antocuni/astroscad/(list of files, cad)

Other CAD files:
v2/pyscad/vendored/gears/gears.scad
