antocuni/astroscad/v2/pyscad/test/screenshots/TestBasic.test_cube.png

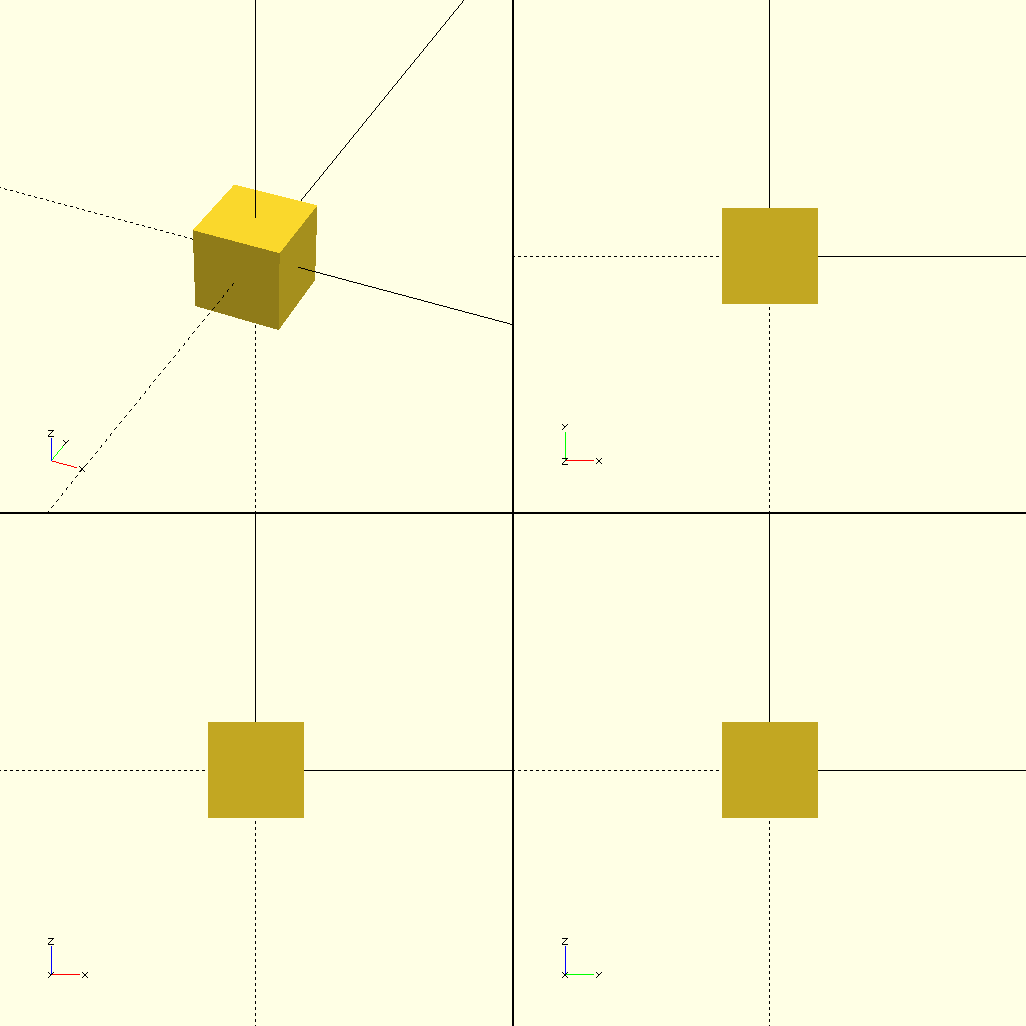
v2/pyscad/test/screenshots/TestBasic.test_cube.png
