antocuni/astroscad/v2/pyscad/test/screenshots/TestBasic.test_cylinder.png

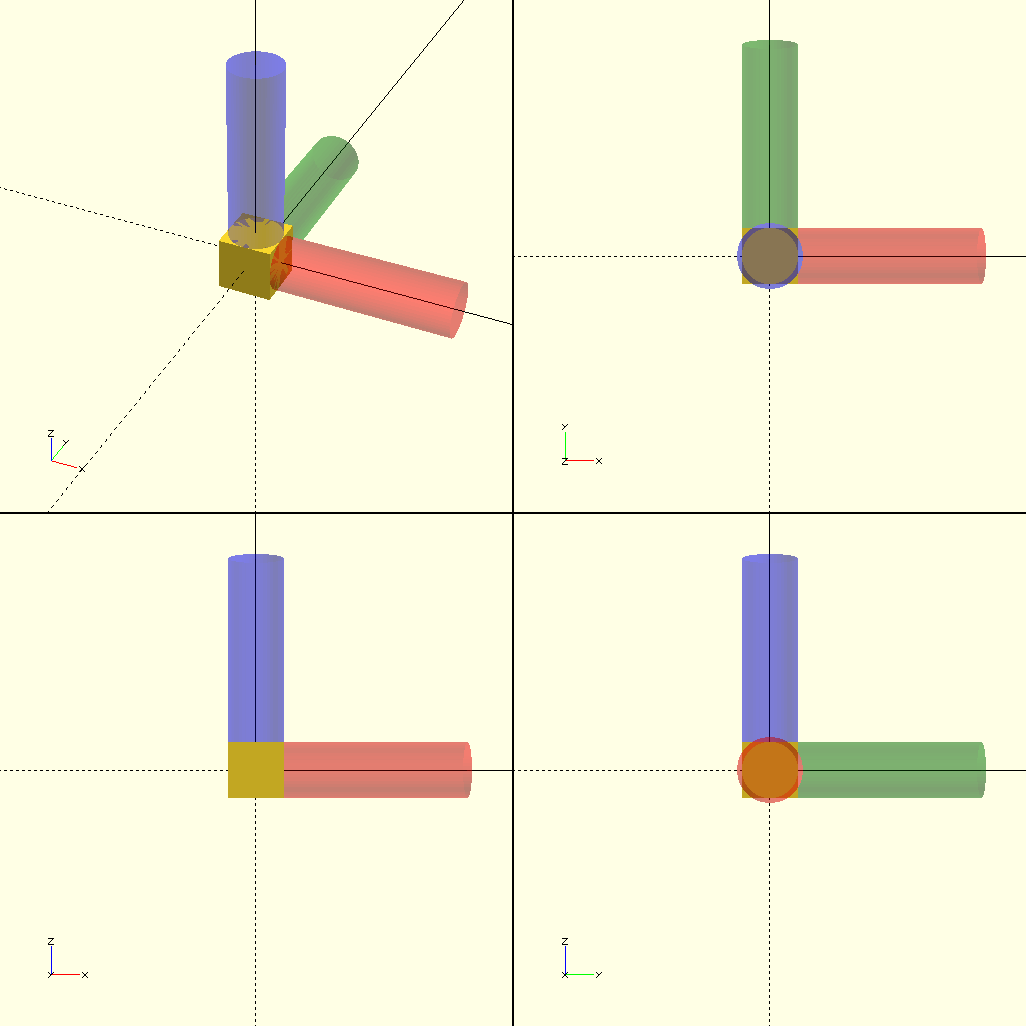
v2/pyscad/test/screenshots/TestBasic.test_cylinder.png
