antocuni/astroscad/v2/pyscad/test/screenshots/TestBasic.test_Difference.png

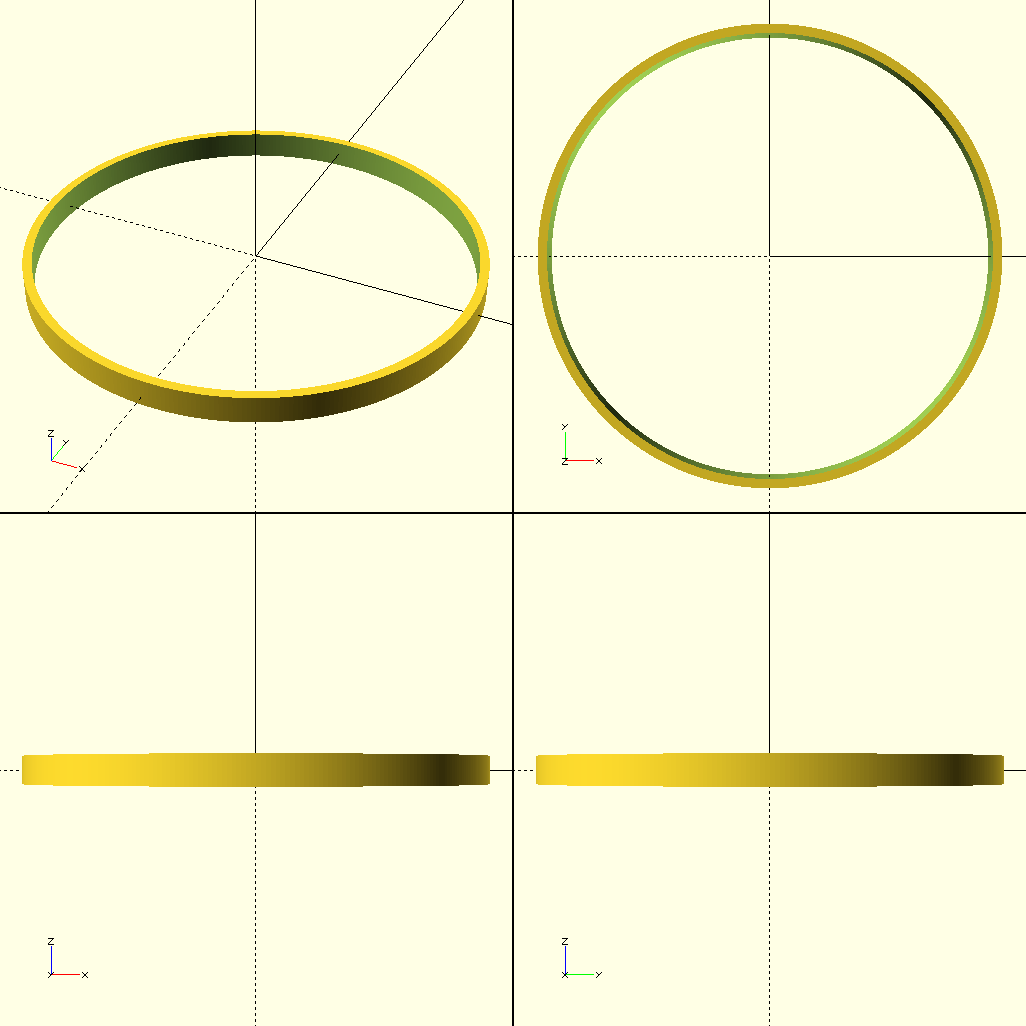
v2/pyscad/test/screenshots/TestBasic.test_Difference.png
