antocuni/astroscad/v2/pyscad/test/screenshots/TestBasic.test_move_to.png

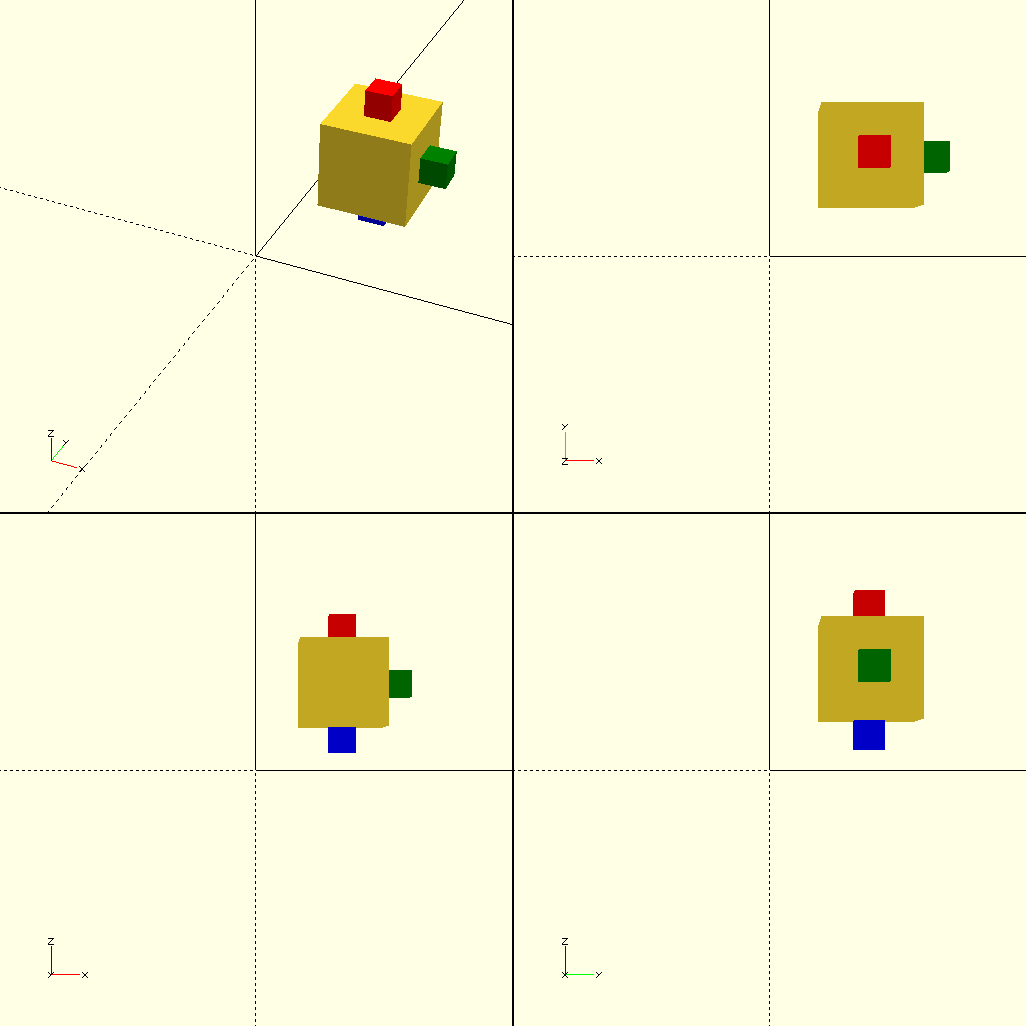
v2/pyscad/test/screenshots/TestBasic.test_move_to.png
