antocuni/astroscad/v2/pyscad/test/screenshots/TestBasic.test_sphere.png

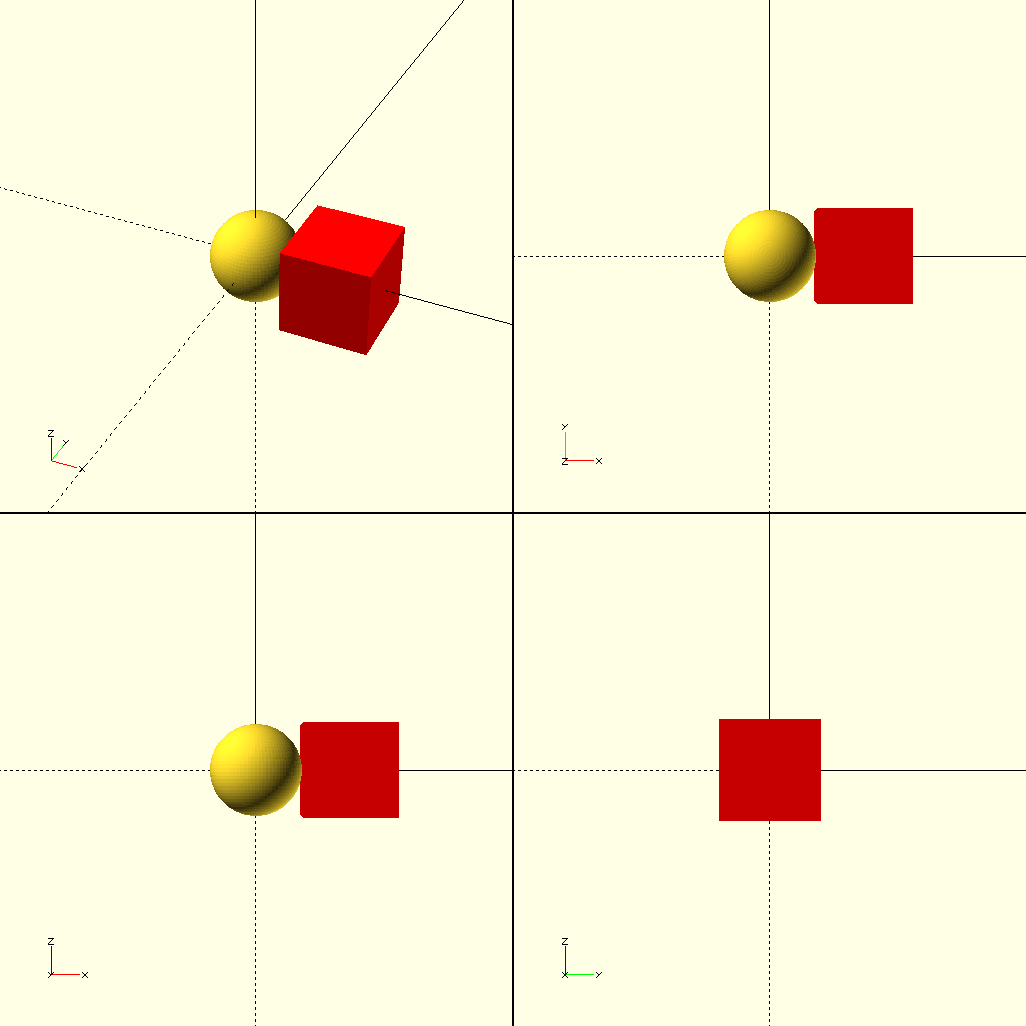
v2/pyscad/test/screenshots/TestBasic.test_sphere.png
