antocuni/astroscad/v2/pyscad/test/screenshots/TestGear.test_bracket.png

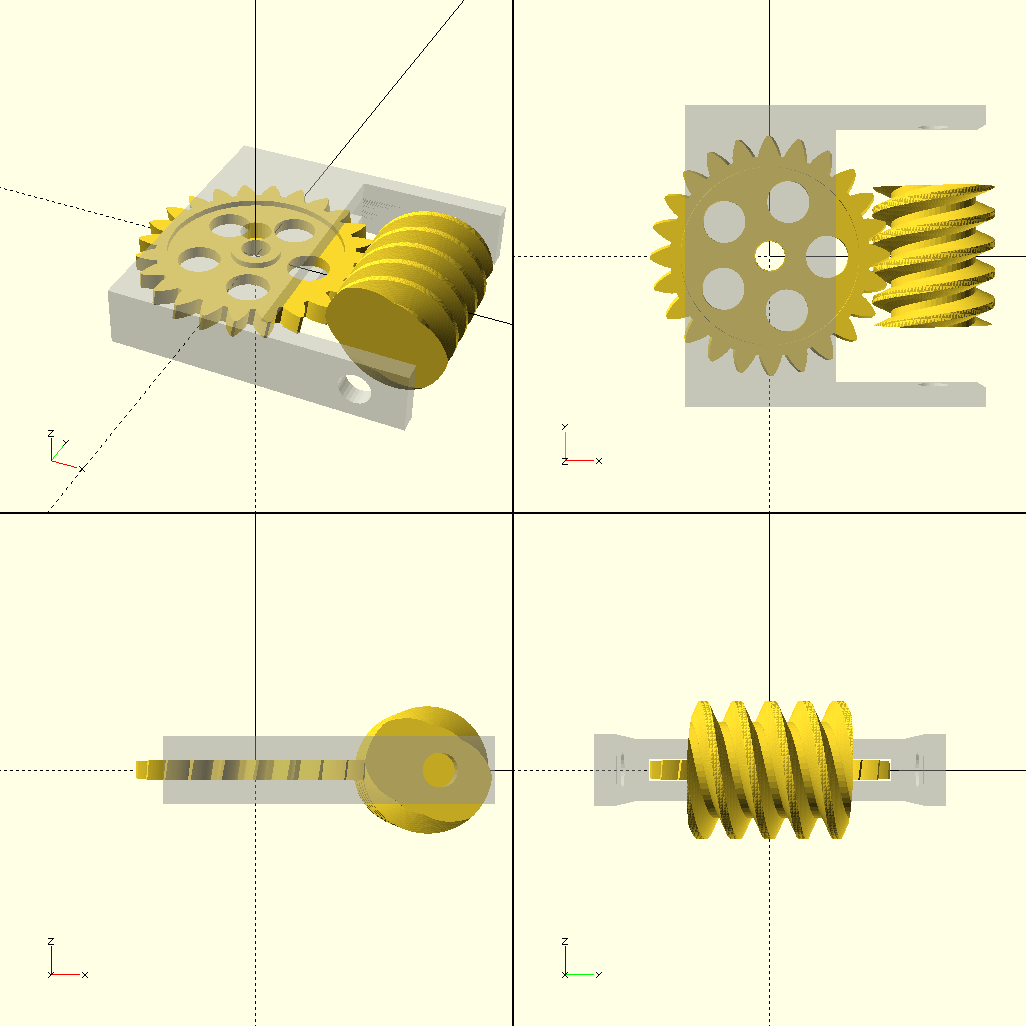
v2/pyscad/test/screenshots/TestGear.test_bracket.png
