antocuni/astroscad/v2/pyscad/test/screenshots/TestGear.test_spur_other_axes.png

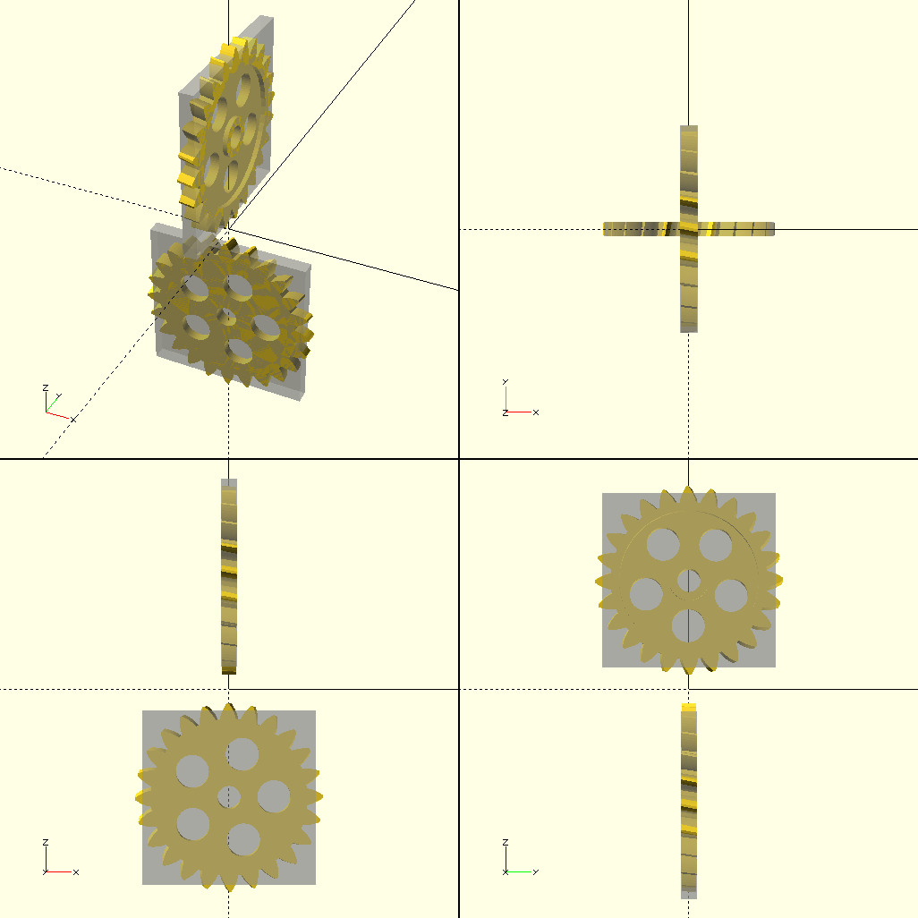
v2/pyscad/test/screenshots/TestGear.test_spur_other_axes.png
