antocuni/astroscad/v2/pyscad/test/screenshots/TestGear.test_spur_simple.png

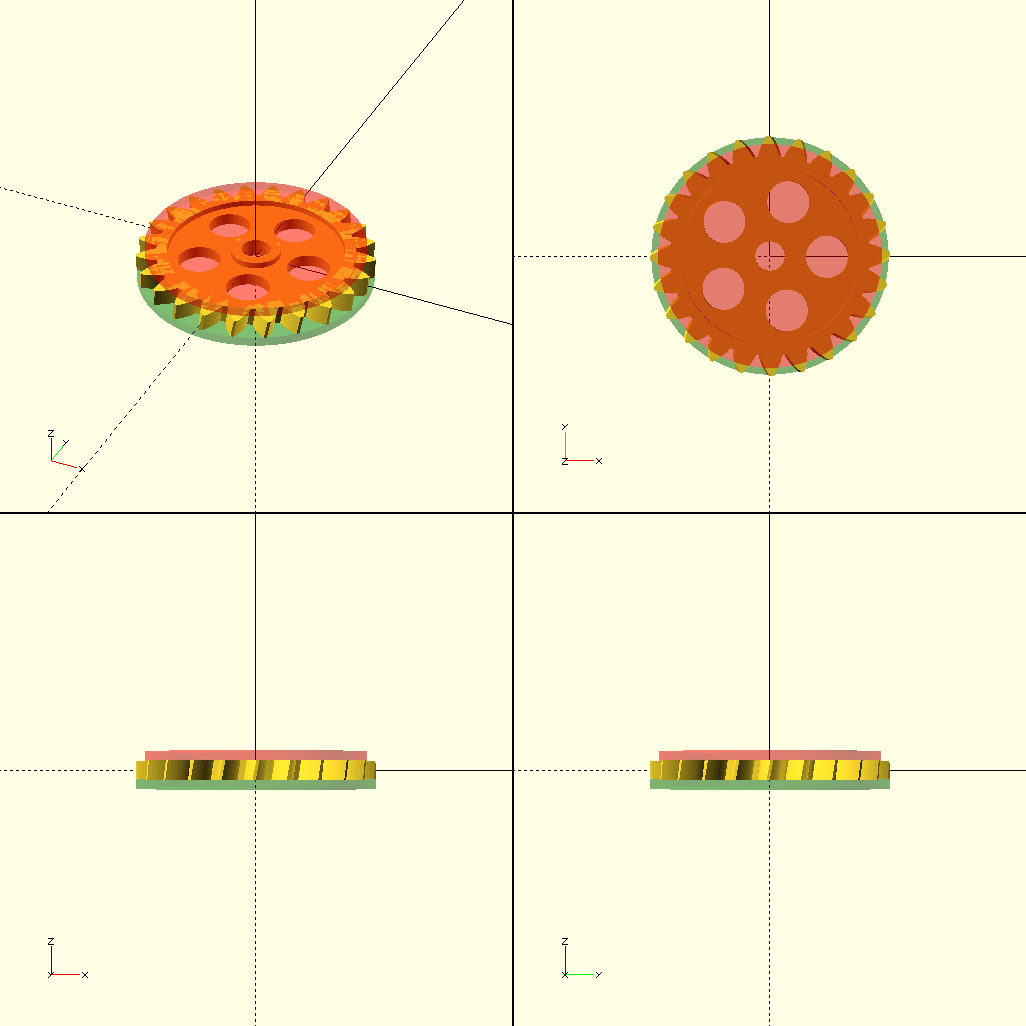
v2/pyscad/test/screenshots/TestGear.test_spur_simple.png
