antocuni/astroscad/v2/pyscad/test/screenshots/TestLib.test_bearing.png

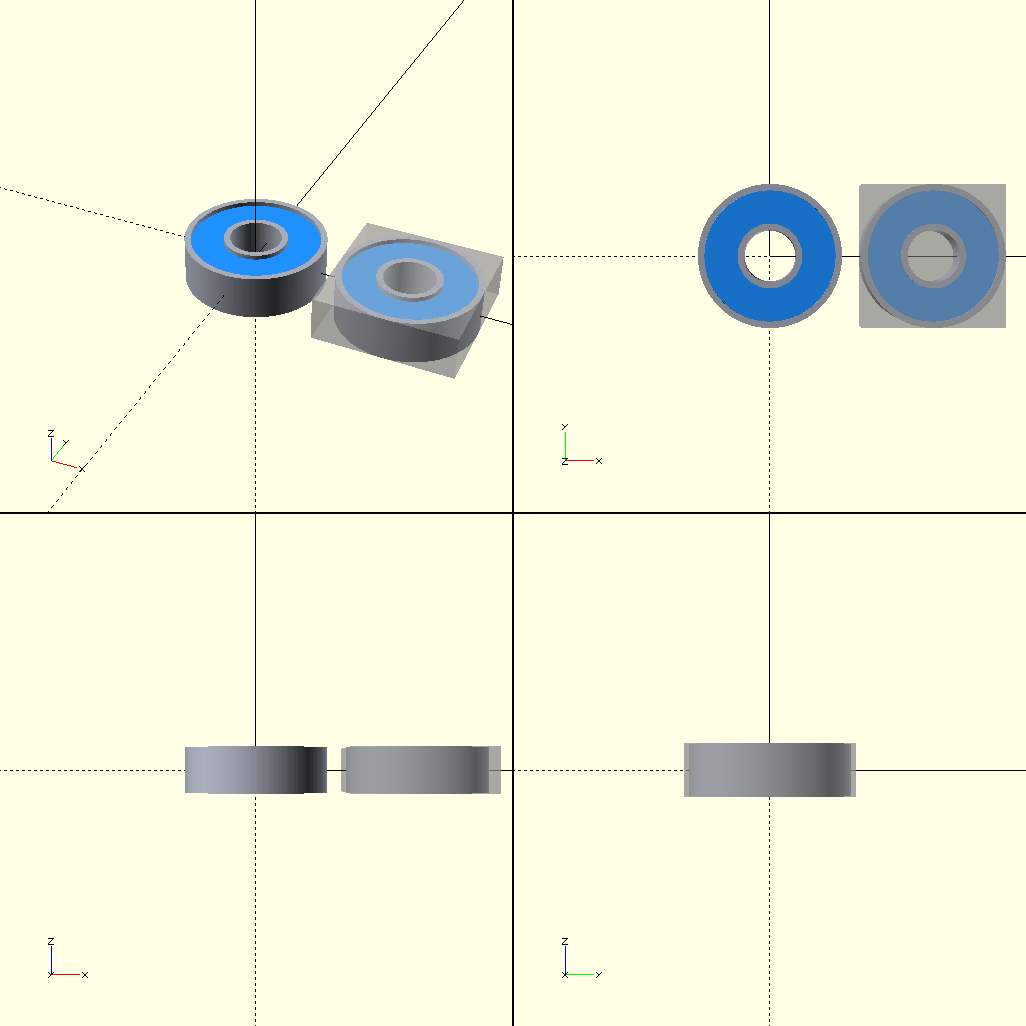
v2/pyscad/test/screenshots/TestLib.test_bearing.png
