antocuni/astroscad/v2/pyscad/test/screenshots/TestRoundHole.test_negative.png

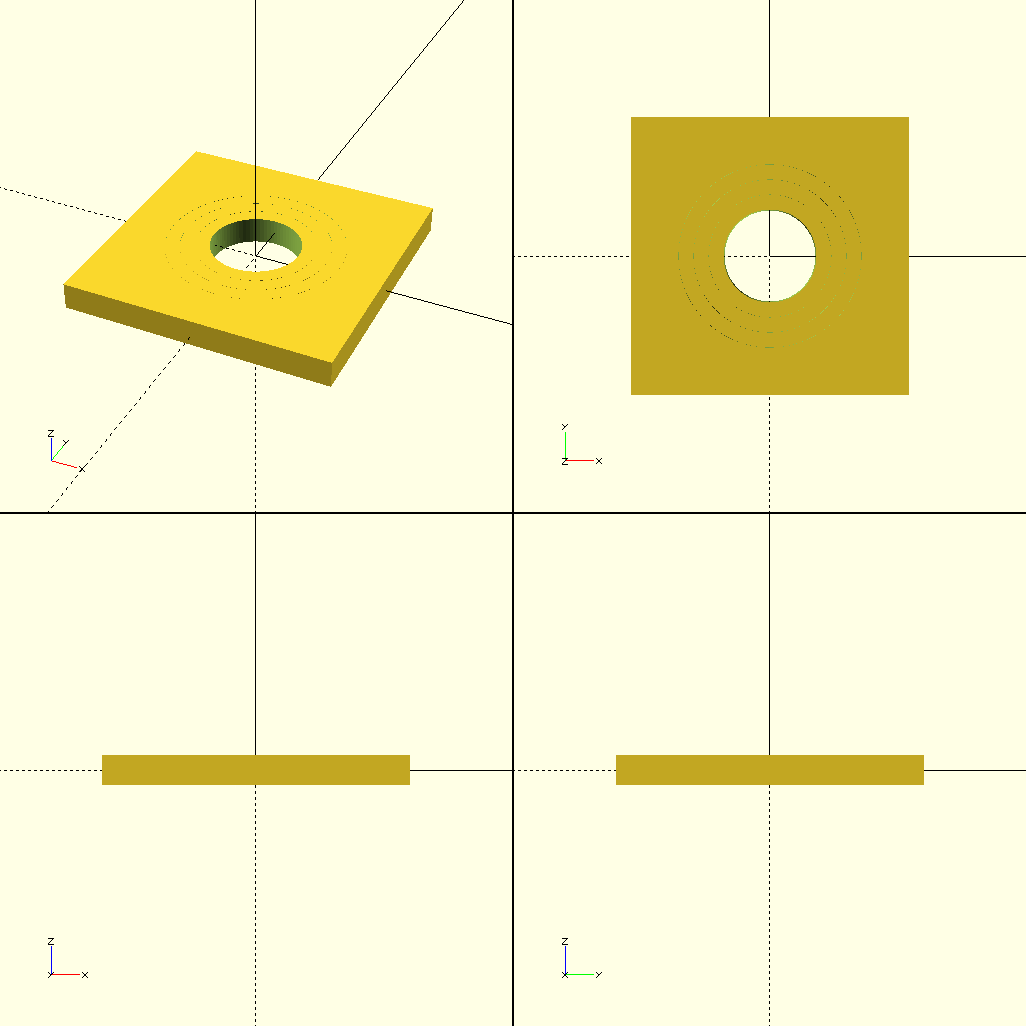
v2/pyscad/test/screenshots/TestRoundHole.test_negative.png
