antocuni/astroscad/v2/pyscad/test/screenshots/TestShapes.test_DonutSlice.png

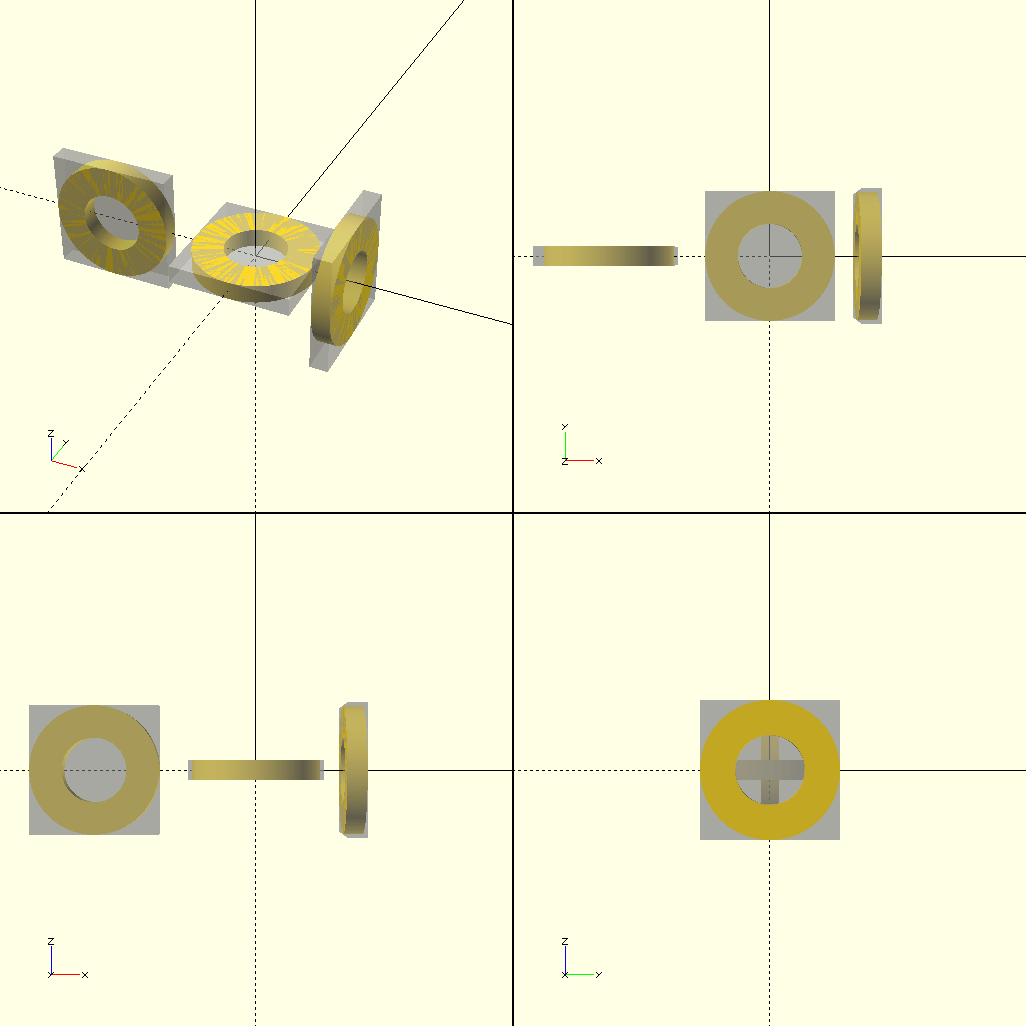
v2/pyscad/test/screenshots/TestShapes.test_DonutSlice.png
