antocuni/astroscad/v2/pyscad/test/screenshots/TestStepper_48BYJ48.test_motor.png

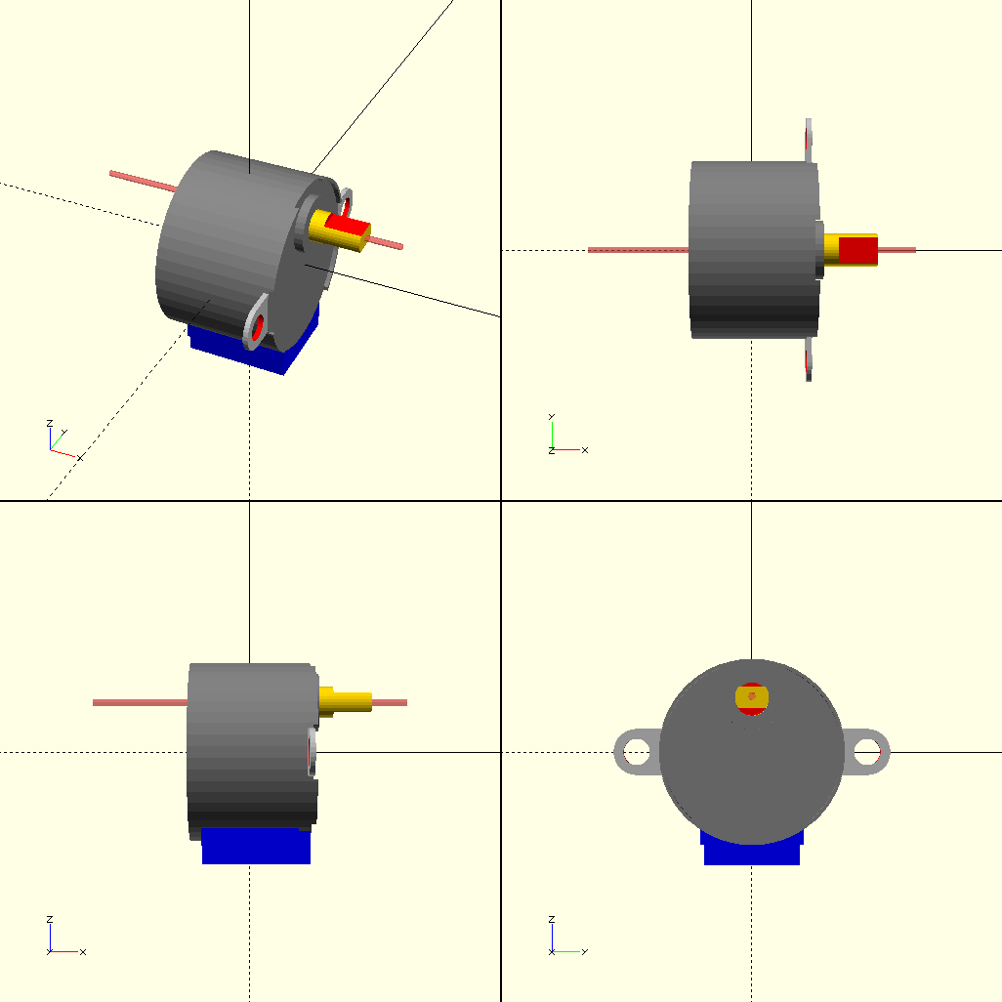
v2/pyscad/test/screenshots/TestStepper_48BYJ48.test_motor.png
