antocuni/astroscad/v2/pyscad/test/screenshots/TestStepper_48BYJ48.test_mounting_holes.png

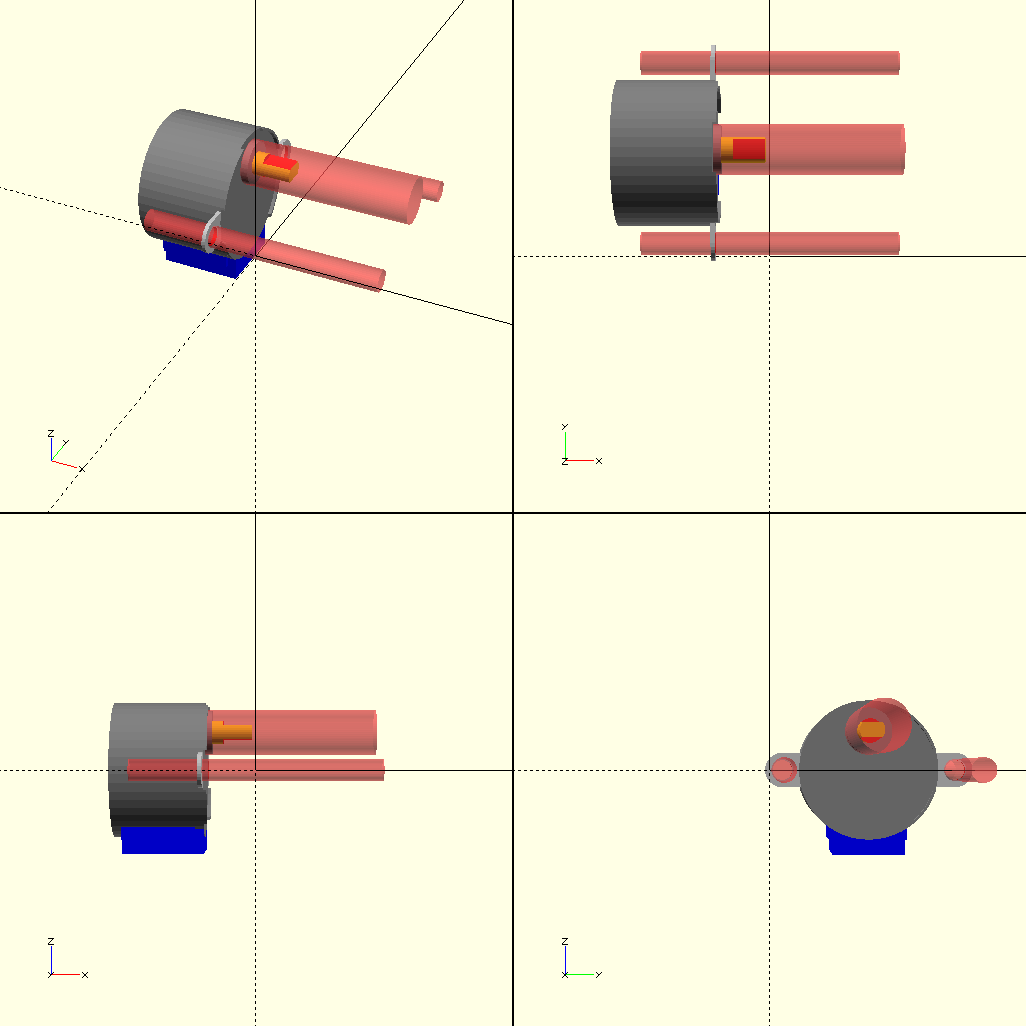
v2/pyscad/test/screenshots/TestStepper_48BYJ48.test_mounting_holes.png
