antocuni/astroscad/v2/try_preview.py

#!/usr/bin/python3

import os
from pyscad import autorender, Cube, Cylinder, Preview

class CubeOrCylinder(Preview):

    def preview(self):
        return Cube(10, 10, 10)

    def render(self):
        return Cylinder(d=10, h=10)


def main():
    return CubeOrCylinder()


if __name__ == '__main__':
    main().autorender()
