antocuni/astroscad/(commit log)

2021-03-17 initial checkin: start to design the upper plate of the tracker
    [astro.scad]
2021-03-17 add the hole for the ball head
    [astro.scad]
2021-03-17 display also the head of the PH38 bolt
    [astro.scad]
2021-03-17 add animation
    [astro.scad]
2021-03-17 make inner_hinge a module of its own
    [astro.scad]
2021-03-17 take the nut into account
    [astro.scad]
2021-03-17 use a more reasonable height for the ball head
    [astro.scad]
2021-03-17 more renaming
    [astro.scad]
2021-03-17 start to model the lower plate
    [astro.scad]
2021-03-17 use a global variable to show vitamins
    [astro.scad]
2021-03-17 display also the bearings
    [astro.scad]
2021-03-18 improve the upper plate
    [astro.scad]
2021-03-18 small tweaks
    [astro.scad]
2021-03-18 more tweaks
    [astro.scad]
2021-03-18 make this hole slightly bigger
    [astro.scad]
2021-03-19 add the threaded rod and a hole in the upper plate
    [astro.scad]
2021-03-19 fix the lower plate
    [astro.scad]
2021-03-19 simplify & fix the upper plate
    [astro.scad]
2021-03-19 add a hole for the PH38 nut
    [astro.scad]
2021-03-19 make the small upper plate shorter, else it covers the PH38 hole
    [astro.scad]
2021-03-19 make the lower plate exactly as thick as the bearing slots
    [astro.scad]
2021-03-19 add a hole for the threaded rod also to the lower plate
    [astro.scad]
2021-03-19 this is the right dimension to comfortably hold a PH14 nut
    [astro.scad]
2021-03-19 This is the precise dimension of my rod
    [astro.scad]
2021-03-19 add slot+hole for the PH14 nut+bolt, to fasten the quick-release plate
    [astro.scad]
2021-03-19 move the ball head closer to the hinge
    [astro.scad]
2021-03-19 add a very rough model of the thrust bearings
    [thrust_bearing.scad]
2021-03-19 add the model for the gear with a nut embedded
    [gear_with_nut.scad, thrust_bearing.scad]
2021-03-19 shift everything down so that the inner nut is precisely centered, it makes it easier to use in the main model
    [gear_with_nut.scad]
2021-03-20 add the driver gear
    [astro.scad, gear_with_nut.scad, thrust_bearing.scad]
2021-03-20 add a thrust bearing and the corresponding washer
    [astro.scad]
2021-03-20 add the upper thrust bearing
    [astro.scad]
2021-03-20 refactor the way the gear cavity is done. This way should be easier to apply it also to the upper plate
    [astro.scad]
2021-03-20 add some notches to the bearing slots, to make it easier to measure angles
    [astro.scad]
2021-03-20 WIP: start to add the gear cap
    [astro.scad, thrust_bearing.scad]
2021-03-20 WIP: start to add pillars to the gear cap
    [astro.scad]
2021-03-20 add holes for the screw
    [astro.scad, screw_holes.scad]
2021-03-20 use the official tolerance
    [astro.scad]
2021-03-20 add a hole for the threaded rod into the gear cap
    [astro.scad]
2021-03-20 add holes for the pillar screws in the lower plate
    [astro.scad]
2021-03-20 add slots for the nuts
    [astro.scad]
2021-03-20 use a higher tolerance, else the screw does not fit comfortably in the hole
    [astro.scad]
2021-03-20 the the nut slot taller
    [astro.scad]
2021-03-20 revert to the old tolerance. If I print with standard settings, it prints fine
    [astro.scad]
2021-03-20 WIP: add the stepper motor and the corresponding gear
    [StepMotor_28BYJ-48.scad, astro.scad, gear_with_nut.scad, stepper.scad]
2021-03-20 make a cavity for the gear cap in the upper plate so that we can still close the tracker
    [astro.scad]
2021-03-20 try another approach to make space for the gear cap
    [astro.scad]
2021-03-20 make it possible to have different upper and lower lengths
    [astro.scad]
2021-03-20 make the whole design simpler
    [astro.scad]
2021-03-20 add a hole for this nut
    [astro.scad]
2021-03-20 as the comment say
    [astro.scad]
2021-03-20 improve the rendering in preview mode
    [astro.scad, gear_with_nut.scad]
2021-03-20 start to add holes for the stepper
    [astro.scad, stepper.scad]
2021-03-20 add the two holes to mount the stepper
    [astro.scad, stepper.scad]
2021-03-20 make the pillars of the gear cap more stable
    [astro.scad]
2021-03-20 slightly enlarge the hole of the gear cap screws
    [astro.scad]
2021-03-20 add a slot for another thrust bearing, in case it will be needed
    [astro.scad]
2021-03-20 add a shaft to the stepper gear, with the appropriate hole
    [astro.scad, stepper.scad]
2021-03-21 add a washer to the stepper gear
    [stepper.scad]
2021-03-21 make a module for stepper_gear in astro.scad, so that we can print it from there with the correct dimensions
    [astro.scad, stepper.scad]
2021-03-21 enlarge a bit this hole, it turned out too tight when printed
    [astro.scad]
2021-03-24 introduce 'curved washers' to keep the rod in place
    [astro.scad]
2021-03-26 these are the best settings for my printer
    [thrust_bearing.scad]
2021-03-26 introduce my_nutHole, which lets to specify the exact height of the nut
    [gear_with_nut.scad]
2021-03-26 use a smaller cut-through hole to improve the quality of the washer holes
    [gear_with_nut.scad]
2021-03-26 refactor curved_washers
    [astro.scad]
2021-03-26 add some todo
    [astro.scad]
2021-04-03 add a more friendly wrapper for cylinder
2021-04-03 create an adapter to put 1/4" screws into a 608 bearing
2021-04-03 add a method to make a bearing slot
2021-04-04 add a bracket to test spur+worm gears
2021-04-04 add some more shortcuts
    [astro.py]
2021-04-04 fix bolt_hole(center=True)
2021-09-04 refactor Cylinder
2021-09-06 attach anchors to Cube and start to write test for that
2021-09-06 fix try_gears in preparation of a bigger refactoring
    [try_gear.py]
2021-09-06 re-implement Cylinder
2021-09-07 refactor how Composite and move_to are implemented: instead of relying on implicitly looking up the PySCADObject attributes, we explicitly keep track of children
2021-09-07 attach useful info such as size, r, d, h to some primitive objects
2021-09-07 vendor the gears library from https://github.com/chrisspen/gears, commit e07935c
    [gears.scad]
2021-09-07 move the logic to set OPENSCADPATH directly into scad.py and remove it from all the scripts. Start to write gears.py which is a wrapper around gears.scad
2021-09-07 play with gears
2021-09-08 introduce a high level WormFactory, and use it to greatly simplify the gears example
    [gears.scad]
2021-09-09 I mistakenly committed a version with local edits. Revert gears.scad back to commit e07935c of https://github.com/chrisspen/gears
    [gears.scad]
2021-11-09 add an option to show the tests inside openscad and make it possible to create cylinders of different orientations
2021-11-09 add a bearing class, inspired by MCAD/bearing.scad
2021-11-09 make it possible to change the camera distance when rendering collages, and use it for test_bearing
2021-11-09 move gears.py into lib/
2021-11-12 introduce a vendored library to render a Manfrotto 200PL plate
    [manfrotto-200PL-003.scad]
2021-11-12 attacch a manfrotto plate to the baseplate
2021-12-19 add the version with holes of the manfrotto plate
2021-12-19 tweak the model to use a real manfrotto plate which will be screwed
2021-12-21 introduce the bearing-bolt adapter and the actual bolt
2021-12-21 make the baseplate higher so that it fully contains the bearing and there is space to attach the photo plate again
2021-12-22 use Spure.bore_d instead of manually subtracting a cylinder
2021-12-23 don't require a specific version of psutil, so that it can use one with linux wheels
2021-12-26 add RoundHole, a Cylinder-like hole which automatically adds reinforing walls
2021-12-27 add screw holes to attach the photo plate to the base plate
2021-12-27 add some extra walls around the central bearing
2021-12-27 show the hex hole inside the PHBolt head, just because
2021-12-27 make it possible to align spur gears along all axes
2021-12-27 re-design WormGear to be more consistent with the rest of the cylinder-like objects. Now it has an 'h' instead of a 'length', it lays on the z axis by default and it's possible to change the orientat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
2021-12-27 star to design the worm gear, and attach a spur to it
2021-12-27 move the worm in the X axis
2021-12-28 start to design the worm mounting bracket
2021-12-28 add the bracket also to the main model
2021-12-28 squeeze everything down: the ball head is on top of the rplate, and the rplate on top top of the base plate. Add a warning if the bolt is too long
    [astro.py]
2021-12-28 add another print
2021-12-29 resume the black color of the ball head, and mod() it only if you need to inspect the bolt inside
2021-12-29 rough attempt to add a semi-configurable calibration system
2021-12-29 add support for making grooves for the manfrotto plate
2021-12-29 add a groove for the manfrotto plate so that it's easier to center
2021-12-29 make it easier to debug the screw hole limit
2021-12-29 move the baseplate so that its bottom is at z=0, and fix a bug in the position of the bearing
    [astro.py]
2022-01-10 make the spur thicker, else the PHBolt is too long for the ball head
    [astro.py]
2022-01-10 enable fast-rendering of worm and spur gears: in this mode, they are rendered as plain cylinders
2022-01-26 fix the length of the PHBolt, which was wrong. In the meantime, add measurements for another 1.25" bolt which I have
    [astro.py]
2022-01-26 we can make the rplate thinner now that the bolt length has been fixed
    [astro.py]
2022-01-27 add a library to render the stepper motor 28BYJ-48
    [StepMotor_28BYJ-48.scad]
2022-01-27 generate mounting holes for the stepper
2022-01-28 introduce the stepper and tweak the worm
2022-01-29 progress on the worm bracket
2022-01-29 make the baseplate a cylinder and add a platform on which will hold the worm bracket
2022-01-29 add screw holes to attach the glides to the rplate, and make it thicker so that we can use screws which are 0.8mm long
2022-01-29 7mm of thickness is enough
2022-01-29 increase a bit the space for the M4 screw head which will fit insite the pillar
2022-01-29 remove the groove for the manfrotto plate, since we are going to print it at the bottom
2022-01-29 complete the motor bracket and attach it to the baseplate
2022-01-29 make sure that the bearing hole and the photo-plate mountinng holes are drilled AFTER we attach the motor bracket
2022-01-30 make the floor smaller and tweak the position of the stepper so that the mounting holes don't touch the bearing
2022-01-30 tweak the bracket
2022-01-30 refactor: make the motor mount a part of its own so that we can change the dimensions more easily if necessary
2022-01-30 put two washers between the worm and ther bearings
2022-01-30 drill a bigger hole in the worm, to use a M4 bolt
2022-01-30 fix this old file
    [stepper.scad]
2022-01-30 complete StepperSpur by adding a shaft which matches the motor shaft
2022-01-31 WIP: start a refactoring to print the worm shaft and the worm itself separately
2022-01-31 re-add the worm on top of the worm shaft
2022-01-31 reposition the stepper worm now that the worm shaft doesn't have the bulge
    [astro.py]
2022-01-31 WIP: refactor how the pillars and bearings are placed
2022-01-31 complete the refactor: now the washers are attached to the worm_shaft, and check that the total length of the shaft matches the bearing-to-bearing distance
2022-01-31 split the worm in two for printing
2022-01-31 back to a circular hole for the worm shaft
2022-01-31 special case myworm when we want to print it
2022-02-03 add a hole useful to rotate the worm with a drill
2022-02-03 we no longer need worm_for_print, but keep it around anyway
    [astro.py]
2022-02-05 place the worm and add some space to the base where to put the motor bracket
2022-02-05 add the worm shaft
2022-02-05 make the spur plate mostly empy inside
2022-02-05 WIP: start to introduce the motor bracket
2022-02-05 place the spokes correctly
    [astrov3.py]
2022-02-05 compute the addendum circle of spur gears
2022-02-05 progress on the motor bracket
2022-02-05 add a floor to the motor bracket
2022-02-05 progress towards attaching the motor bracket to the base plate
2022-02-05 improve the bottom plate / motor bracket connection
2022-02-07 drill countersink holes in the top plate
2022-02-07 refactor the motor_bracket_floor and improve the joint with the bottom plate
2022-02-07 ensure that there is enough room to place the stepper
2022-02-08 add holes for the manfrotto plate
2022-02-08 tweak the stepper mounting bracket
2022-02-08 manually tweak the measures of the worm shaft so that I can use the one which I have already printed
2022-02-08 make a stronger rim for the bearings
2022-02-08 we need a longer shaft
2022-02-08 add another hole to attach the motor_bracket to the bottom_plate
2022-03-03 introduce Herringbone gears (untested)
2022-03-03 make it possible to add mounting holes without the central hole
2023-02-02 (antocuni, andreamrl) model the electronic board for the tracker v1
2023-02-07 (antocuni, andremrl) model the DSUB connector
2023-03-09 andrea,antonio: model usb power connector and move dsub accordingly
2025-01-01 add a command to import STL
